MichalBogoryja/JumpingRobot_ROCO507/Images/Robot_wheels.jpg

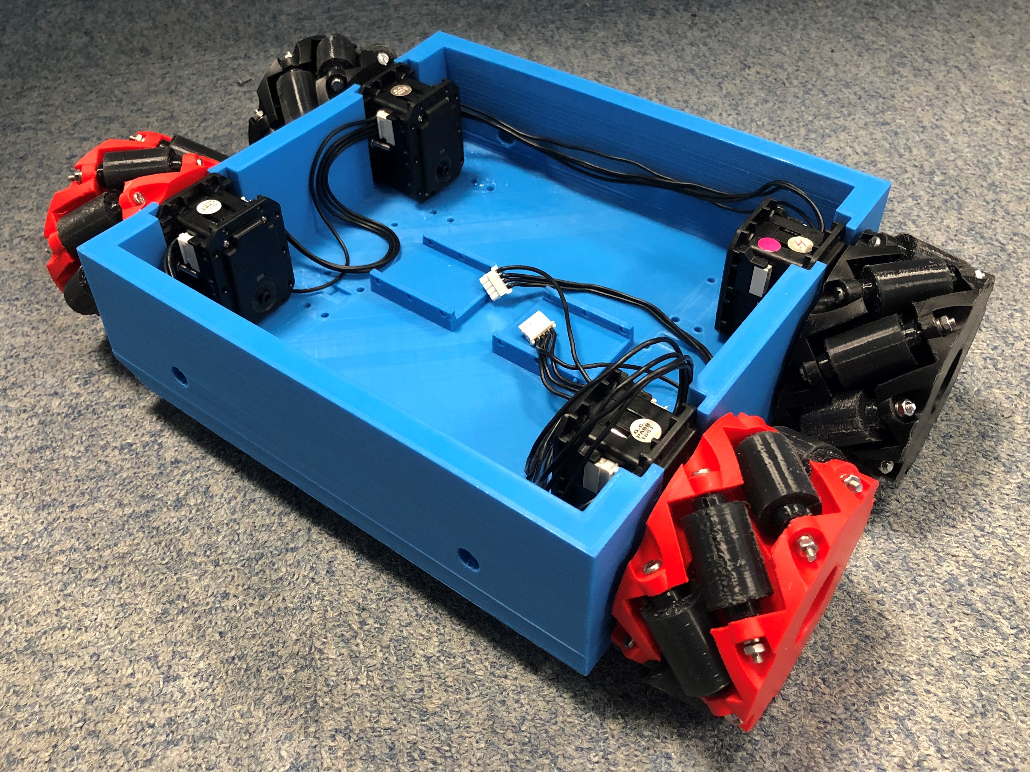
Images/Robot_wheels.jpg
