MichalBogoryja/JumpingRobot_ROCO507/Images/Leg_v1.jpg

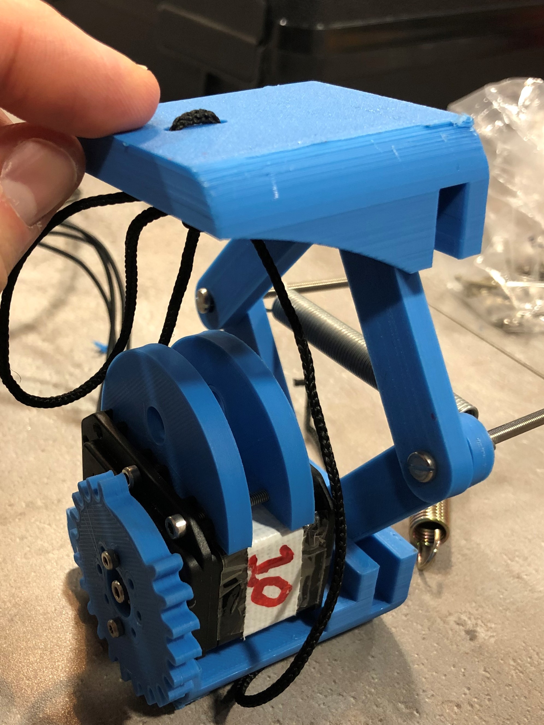
Images/Leg_v1.jpg
