MichalBogoryja/JumpingRobot_ROCO507/Images/Leg_final.jpg

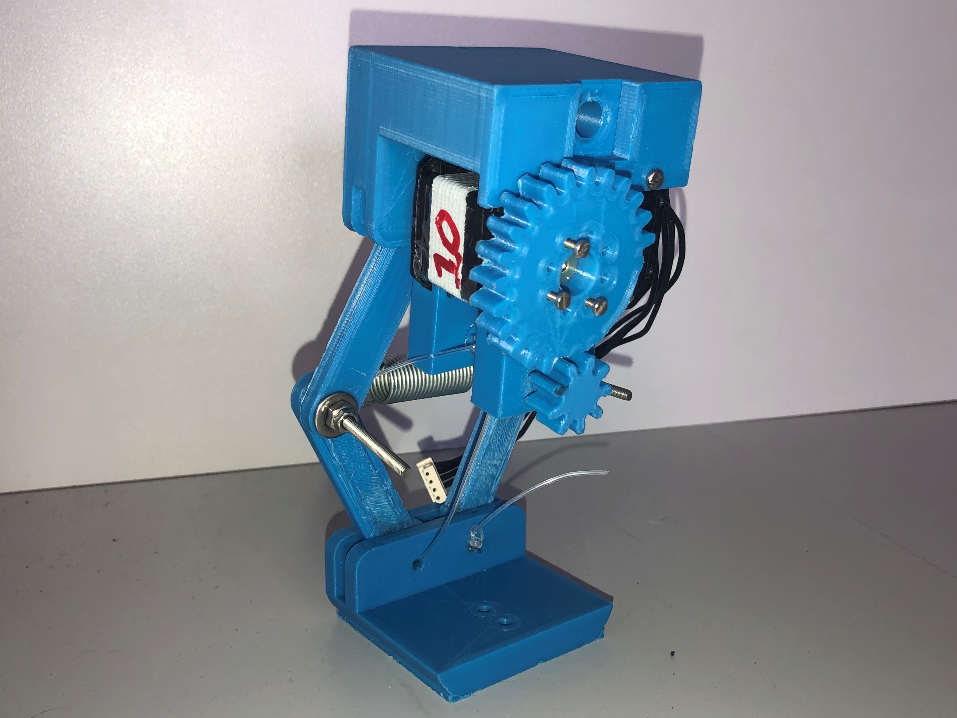
Images/Leg_final.jpg
