MichalBogoryja/JumpingRobot_ROCO507/Images/Robot_design_final.png

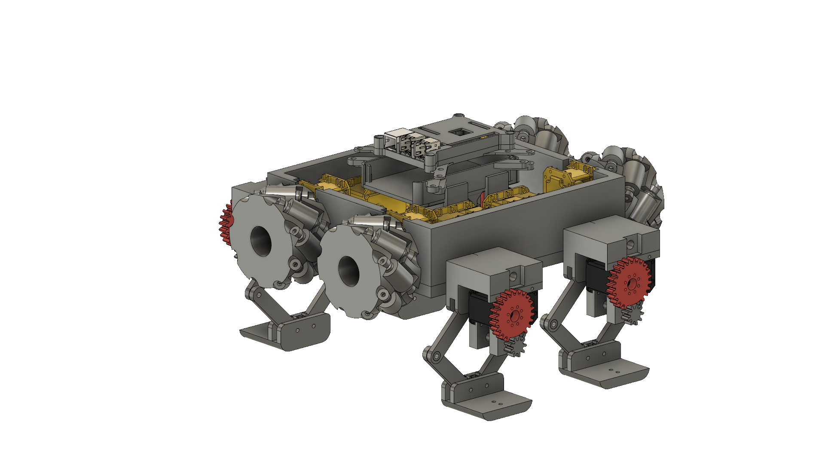
Images/Robot_design_final.png
