MichalBogoryja/JumpingRobot_ROCO507/Images/Robot_design_v1.png

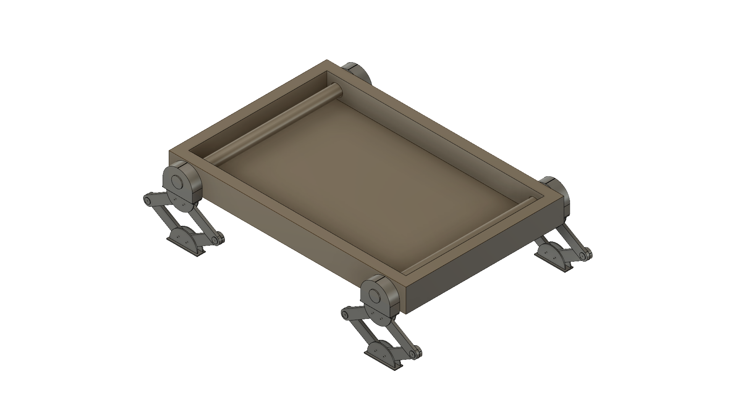
Images/Robot_design_v1.png
