MichalBogoryja/JumpingRobot_ROCO507/Images/Robot_design_v2.png

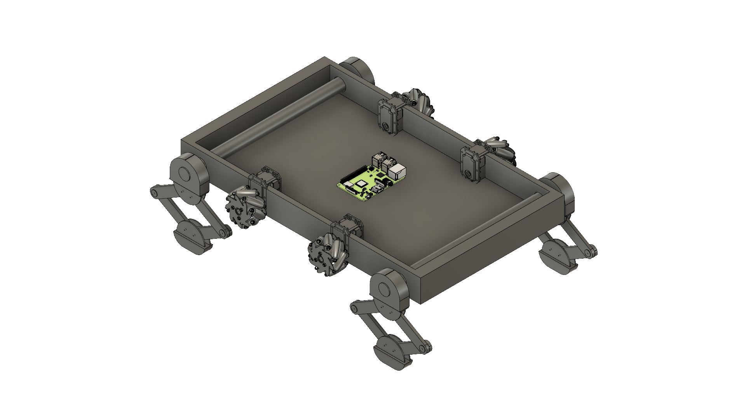
Images/Robot_design_v2.png
