MichalBogoryja/JumpingRobot_ROCO507/Images/Robot_design_v3.png

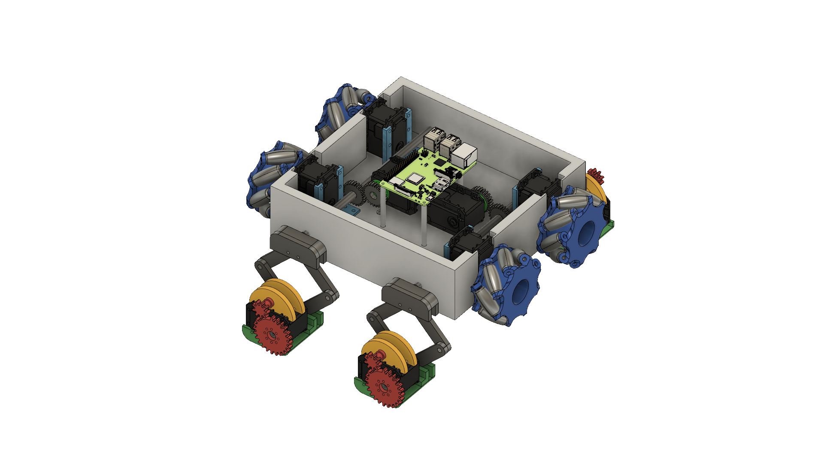
Images/Robot_design_v3.png
