MichalBogoryja/JumpingRobot_ROCO507/3D designs/Leg_extended.stl

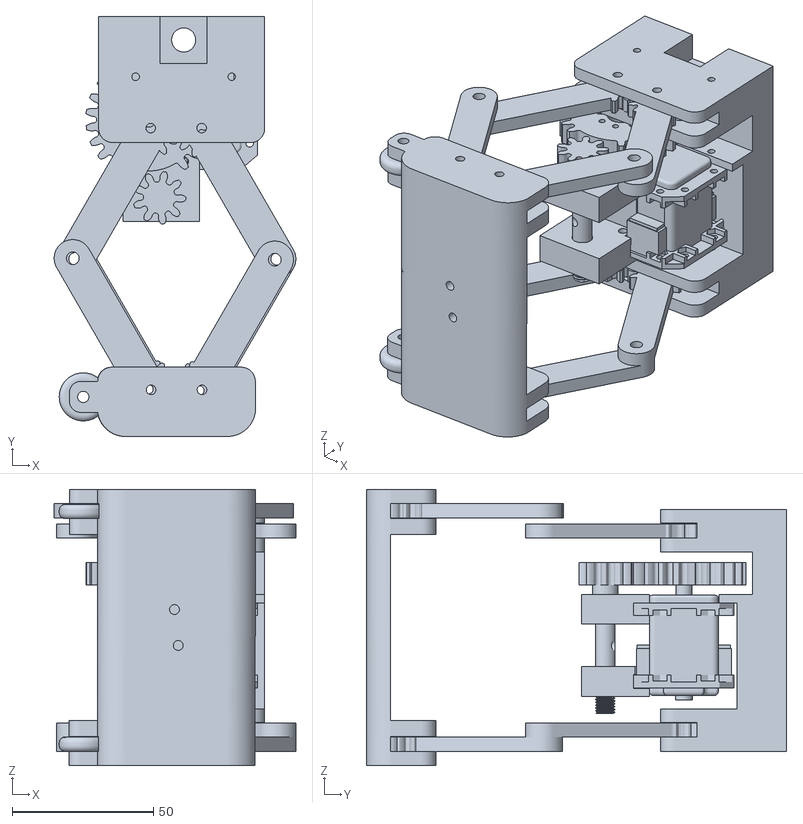
[picture p24: CAD file, 2019-05-31]
3D designs/Leg_extended.stl
85.4 x 148.5 x 97.6
