MichalBogoryja/JumpingRobot_ROCO507/3D designs/Leg_final.stl

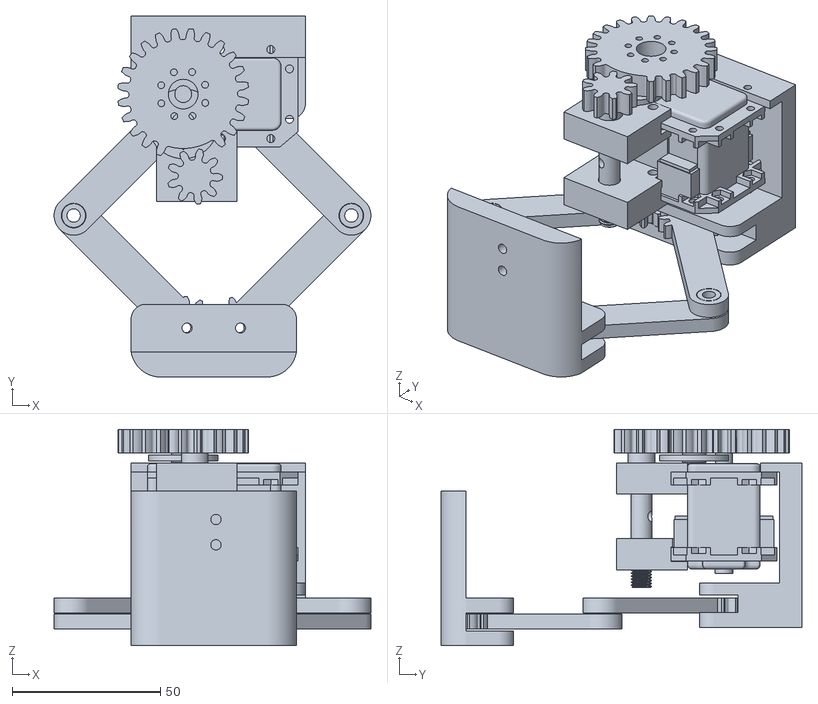
[picture p25: CAD file, 2019-05-31]
3D designs/Leg_final.stl
106.7 x 121.6 x 72.8
