MichalBogoryja/JumpingRobot_ROCO507/3D designs/Leg_v1.stl

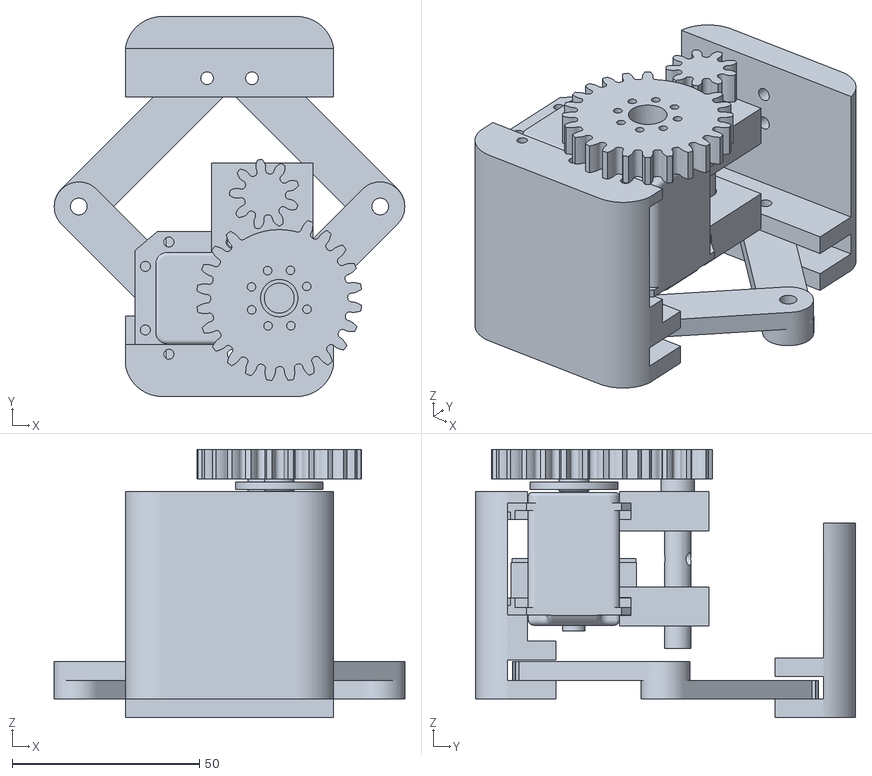
[picture p26: CAD file, 2019-05-31]
3D designs/Leg_v1.stl
93.7 x 101.6 x 71.8
