MichalBogoryja/JumpingRobot_ROCO507/FEA results/Fig.11 a - FEA test of first version of the wheel.png

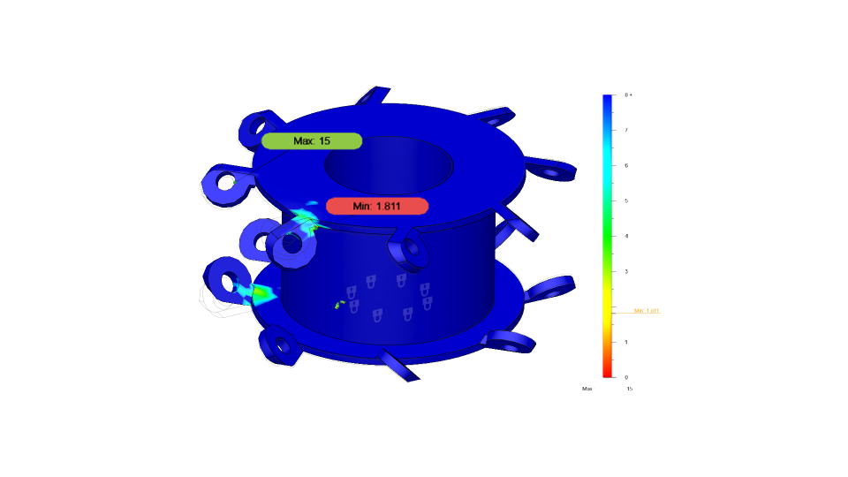
FEA results/Fig.11 a - FEA test of first version of the wheel.png
