MichalBogoryja/JumpingRobot_ROCO507/FEA results/Fig.11 b - FEA test of final version of the wheel.png

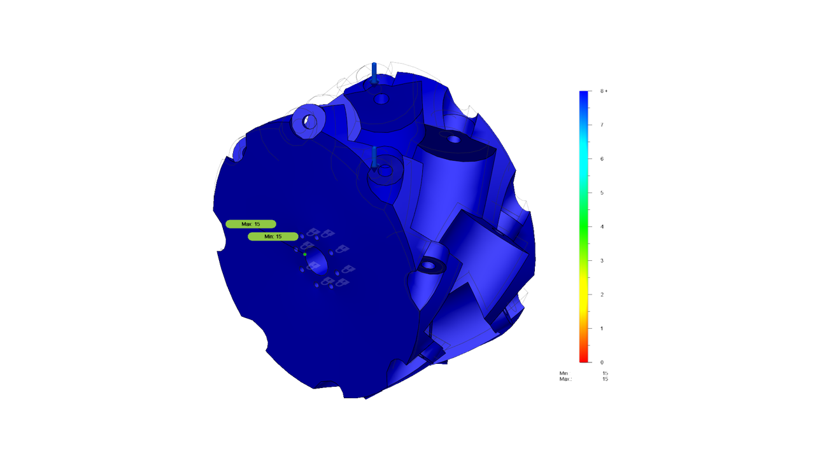
FEA results/Fig.11 b - FEA test of final version of the wheel.png
