MichalBogoryja/JumpingRobot_ROCO507/FEA results/Fig.13 a - FEA test of intial version of the leg.png

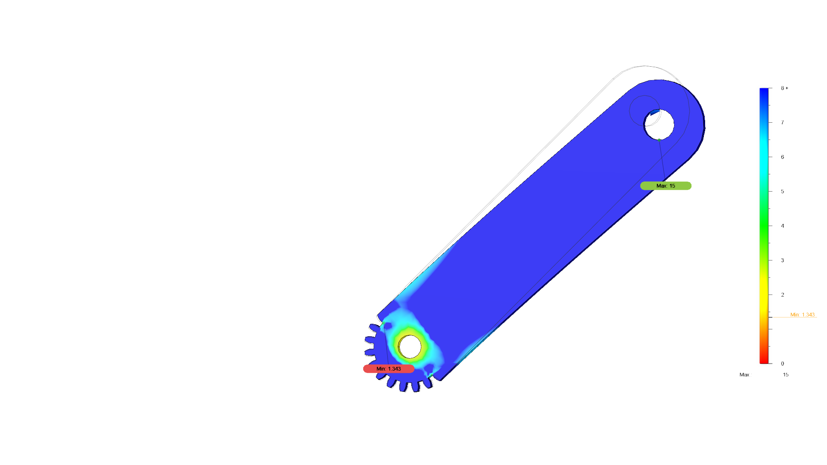
FEA results/Fig.13 a - FEA test of intial version of the leg.png
