MichalBogoryja/JumpingRobot_ROCO507/FEA results/Fig.13 b - FEA test of final version of the leg.png

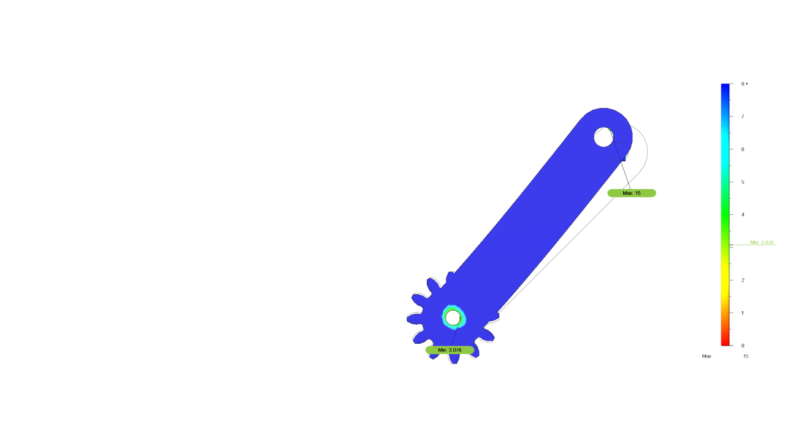
FEA results/Fig.13 b - FEA test of final version of the leg.png
