MichalBogoryja/JumpingRobot_ROCO507/src/tilt.yaml

leg_back_left_controller:
    controller:
        package: dynamixel_controllers
        module: joint_position_controller
        type: JointPositionController
    joint_name: tilt_joint
    joint_speed: 2
    motor:
        id: 10
        init: 0
        min: 0
        max: 4095

leg_front_right_controller:
    controller:
        package: dynamixel_controllers
        module: joint_position_controller
        type: JointPositionController
    joint_name: tilt_joint
    joint_speed: 2
    motor:
        id: 11
        init: 0
        min: 0
        max: 4095

leg_front_left_controller:
    controller:
        package: dynamixel_controllers
        module: joint_position_controller
        type: JointPositionController
    joint_name: tilt_joint
    joint_speed: 2
    motor:
        id: 12
        init: 0
        min: 0
        max: 4095

leg_back_right_controller:
    controller:
        package: dynamixel_controllers
        module: joint_position_controller
        type: JointPositionController
    joint_name: tilt_joint
    joint_speed: 2
    motor:
        id: 13
        init: 0
        min: 0
        max: 4095
        
front_left_legs_folding_controller:
    controller:
        package: dynamixel_controllers
        module: joint_position_controller
        type: JointPositionController
    joint_name: tilt_joint
    joint_speed: 2
    motor:
        id: 6
        init: 0
        min: 0
        max: 4095
        
back_left_legs_folding_controller:
    controller:
        package: dynamixel_controllers
        module: joint_position_controller
        type: JointPositionController
    joint_name: tilt_joint
    joint_speed: 2
    motor:
        id: 7
        init: 0
        min: 0
        max: 4095
        
front_right_legs_folding_controller:
    controller:
        package: dynamixel_controllers
        module: joint_position_controller
        type: JointPositionController
    joint_name: tilt_joint
    joint_speed: 2
    motor:
        id: 8
        init: 0
        min: 0
        max: 4095
        
back_right_legs_folding_controller:
    controller:
        package: dynamixel_controllers
        module: joint_position_controller
        type: JointPositionController
    joint_name: tilt_joint
    joint_speed: 2
    motor:
        id: 9
        init: 0
        min: 0
        max: 4095
