MichalBogoryja/JumpingRobot_ROCO507/(commit log)

2019-05-12 Launch file for joint motors
    The launch file that will load controller parameters to the parameter server and start up the controller.
2019-05-12 Joint motors controller
    File containing all parameters that are necessary for controller of motors in the joint mode
2019-05-12 Wheel motors controller
    File containing all parameters that are necessary for controller of motors in the wheel mode
2019-05-12 Added folding
    Added two motors, which control folding
2019-05-12 Added motors used for folding
2019-05-14 Added two more motors used for folding
2019-05-14 Leg_final
    Picture of the final version of the leg
2019-05-14 Picture of the final version of the leg
2019-05-14 Picture of the first version of the leg
2019-05-14 Picture of the robot with only wheels mounted
2019-05-31 Added legs folding
2019-05-31 Visualisation of propose evaluation of the leg
    Leg made stronger and easier to fold
2019-05-31 The first version of the leg
    [Leg_v1.stl]
2019-05-31 The final version of the leg
    [Leg_final.stl]
2019-05-31 The propoed evalutaion of the leg
    [Leg_extended.stl]
2019-06-01 FEA test of the final version of the leg
2019-06-01 FEA test of the first version of the leg
2019-06-01 FEA test of the final version of the wheel
2019-06-01 FEA test of the first version of the wheel
2019-06-05 All versions of the wheels
